woreno/arduino-nano-Atmel-parallel-EEPROM-programmer/EEPROMs select switches.png

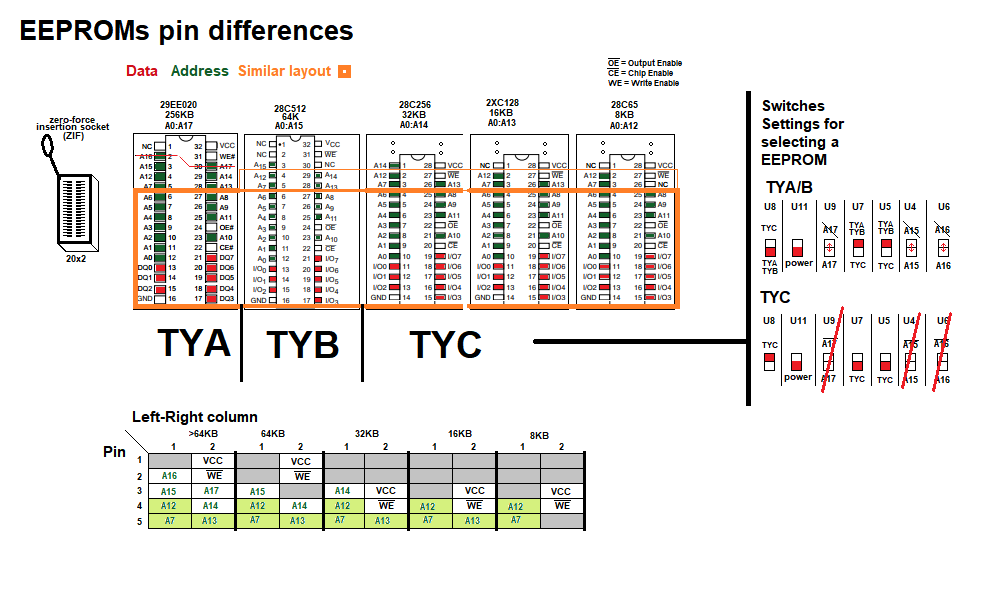
EEPROMs select switches.png
