woreno/arduino-nano-Atmel-parallel-EEPROM-programmer/KICAD/plel.kicad_pcb

## KiCad design KICAD/plel.kicad_pcb (2026-11-10)

Schematic: plel.sch

Parts:
C1: C; standard_2pins_half
R1, R2, R3, R4, R5: R; standard_2pins
U1, U3: 74HC595; standard_DIP_16Pins
U2: ArduinoNano; Arduino_Nano
U4, U5, U6, U7, U8, U9, U10, U11: flipSwitch; mini_flipswitch2.54
Z1: ZIFsocket20_Memory; ZIF socket

Connections:
+5V: R1.1, R2.1, R3.1, R4.1, R5.1, U1.16 (VCC), U3.16 (VCC), U11.1 (line1)
/A0: U3.6 (QG), Z1.12 (A0)
/A1: U3.5 (QF), Z1.11 (A1)
/A2: U3.4 (QE), Z1.10 (A2)
/A3: U3.3 (QD), Z1.9 (A3)
/A4: U3.2 (QC), Z1.8 (A4)
/A5: U3.1 (QB), Z1.7 (A5)
/A6: U3.15 (QA), Z1.6 (A6)
/A7: U1.7 (QH), Z1.5 (A7)
/A8: U1.6 (QG), Z1.35 (A8)
/A9: U1.5 (QF), Z1.34 (A9)
/A10: U1.4 (QE), Z1.31 (A10)
/A11: U1.3 (QD), Z1.33 (A11)
/A12: U1.2 (QC), Z1.4 (A12)
/A13: U1.1 (QB), Z1.36 (A13///NC)
/A14: U1.15 (QA), U5.1 (line1), U7.3 (line2)
/CLOCK_SHIFT: U1.11 (SRCLK), U2.21, U3.11 (SRCLK)
/CLOCK_STORE: U1.12 (RCLK), U2.22, U3.12 (RCLK)
/D0: U2.23, Z1.13 (D0), Z1.19, Z1.22
/D1: U2.24, Z1.14 (D1), Z1.18, Z1.23
/D2: U2.25, Z1.15 (D2), Z1.24
/D3: U2.26, Z1.25 (D3)
/D4: U2.27, Z1.26 (D4)
/D5: U2.28, Z1.27 (D5)
/D6: U2.29, Z1.28 (D6)
/D7: U2.30, Z1.29 (D7)
/MEMPOWER: C1.2, U8.3 (line2), U11.2 (short), Z1.40 (VCC/NC)
/SERIAL_DATA: U1.14 (SER), U2.20
/~OE: U3.7 (QH), Z1.32 (~OE)
/~WE: U2.1, U7.1 (line1), Z1.39 (~WE/NC)
GND: C1.1, U1.8 (GND), U1.13 (~OE), U2.14, U3.8 (GND), U3.13 (~OE), U4.1 (line1), U6.1 (line1), U9.1 (line1), U11.3 (line2), Z1.16 (GND), Z1.30 (~CE)
unnamed: R1.2, U3.10 (~SRCLR)
unnamed: R2.2, U1.10 (~SRCLR)
unnamed: R3.2, U4.3 (line2)
unnamed: R4.2, U6.3 (line2)
unnamed: R5.2, U9.3 (line2)
unnamed: U1.9 (QH'), U3.14 (SER)
unnamed: U4.2 (short), U5.3 (line2)
unnamed: U5.2 (short), Z1.3 (A15/A14/NC)
unnamed: U6.2 (short), Z1.2 (A16/NC)
unnamed: U7.2 (short), Z1.37 (A14/~WE)
unnamed: U8.1 (line1), U9.2 (short)
unnamed: U8.2 (short), Z1.38 (A17/NC/VCC)
unnamed: U2.17, U10.2 (short)
unnamed: U2.16, U10.3 (line2)

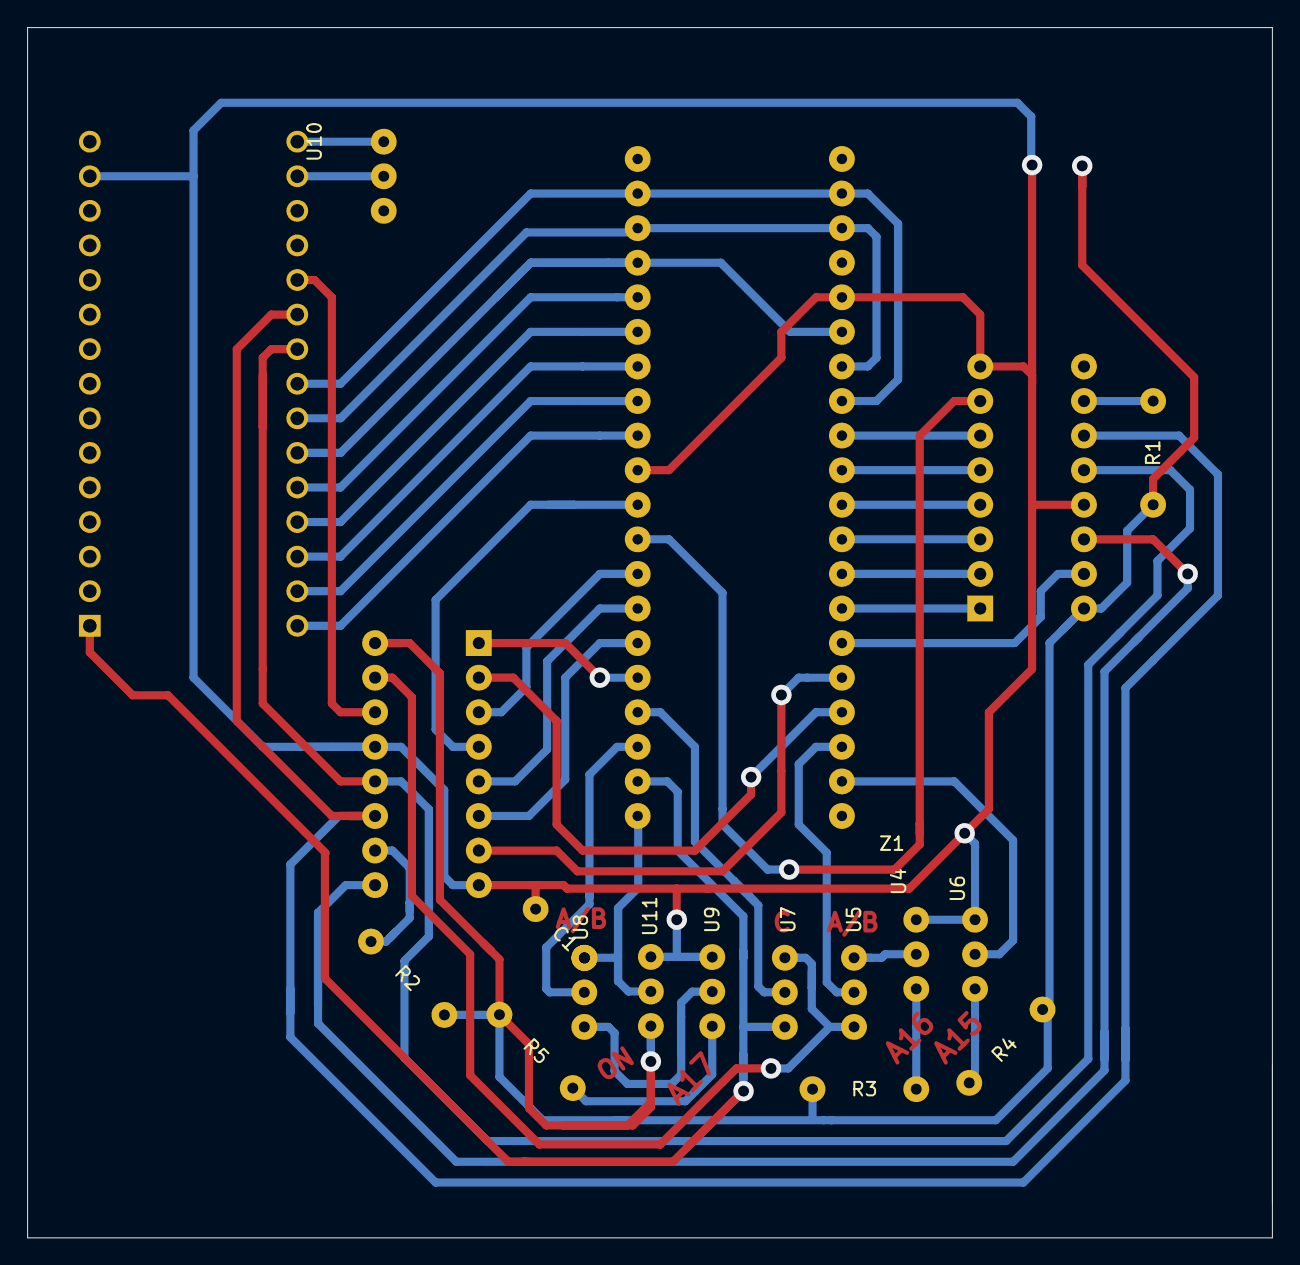
[picture p2: board plel.kicad_pcb from above]

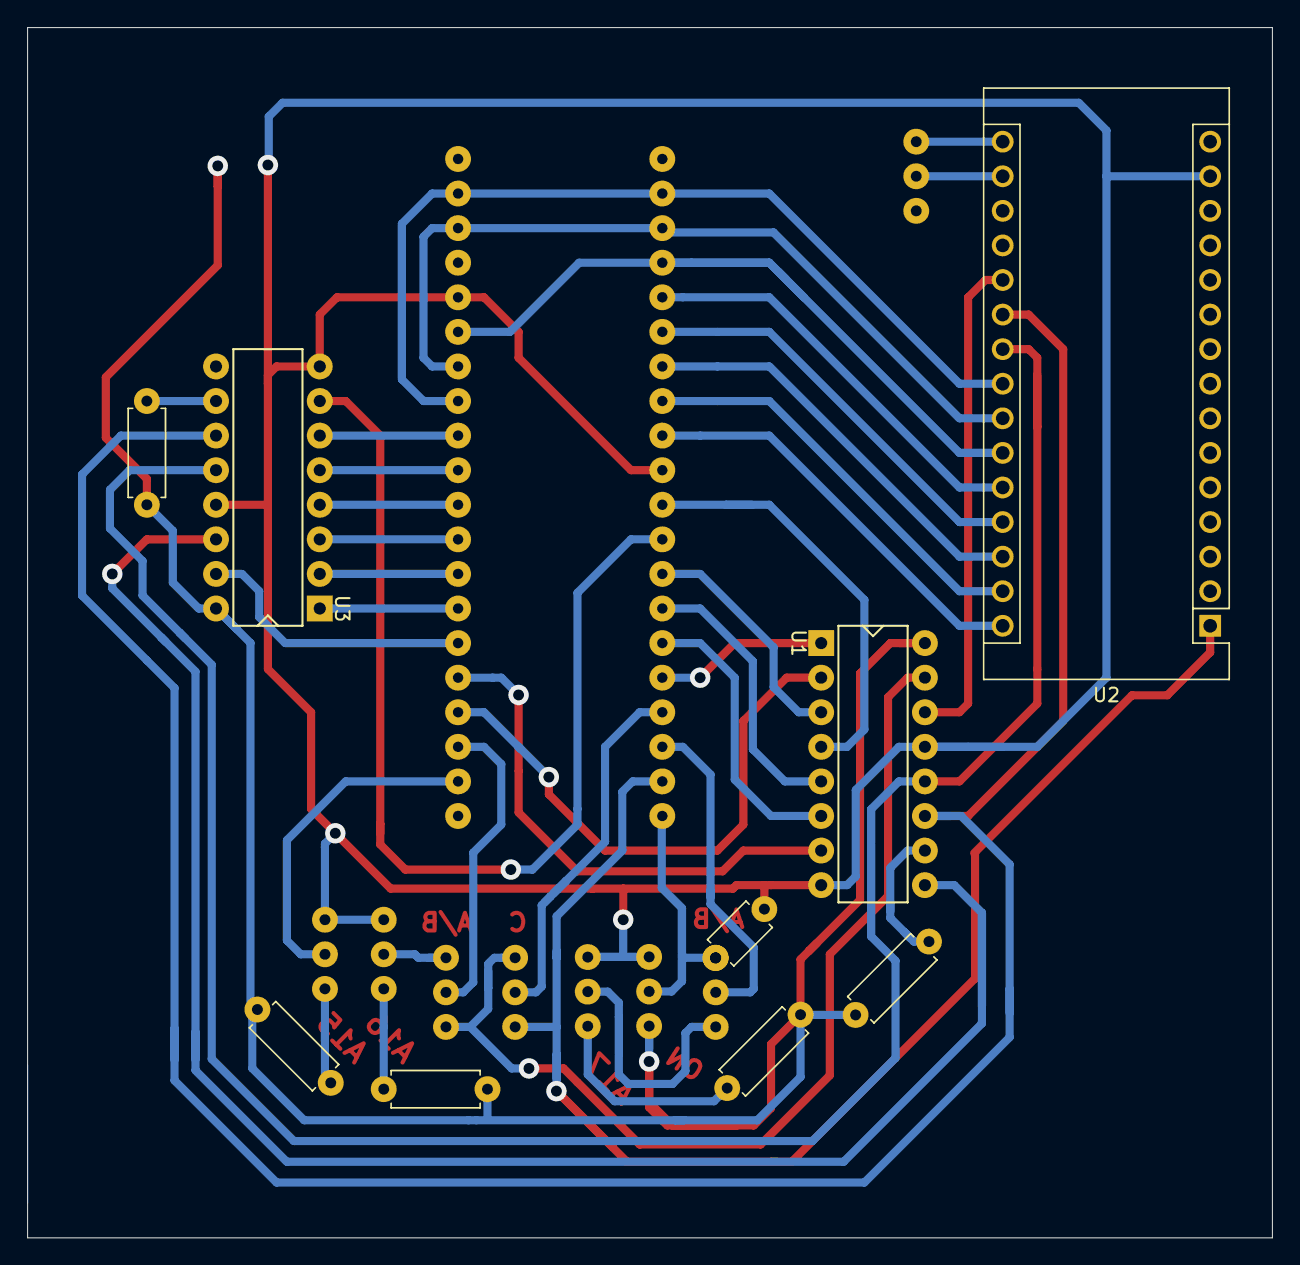
[picture p3: board plel.kicad_pcb from below]

Board: 2 copper layers, 91.4 x 88.9 mm, 18 parts (3 on the bottom side), 45 nets.
